cdrfiuba/seguidor_de_linea/models/Rueda.FCStd

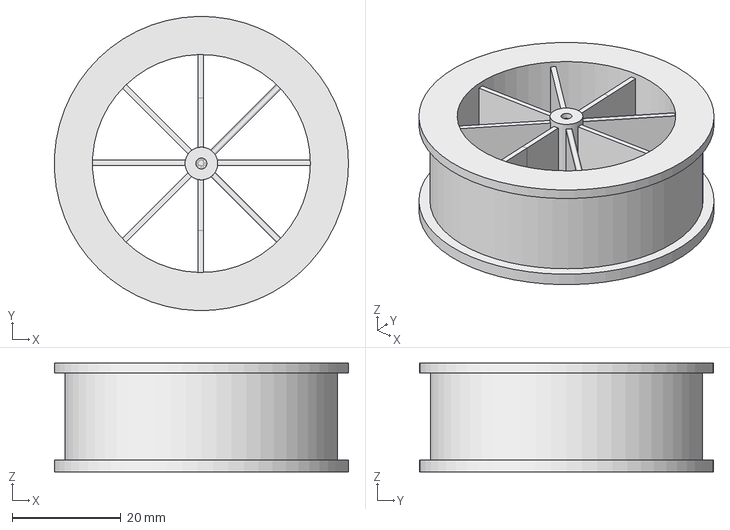
[picture p29: CAD file, 2025-07-30]
models/Rueda.FCStd
54.0 x 54.0 x 20.0 mm
