cdrfiuba/seguidor_de_linea/modulo_seguidor/models/Arduino Nano.stl

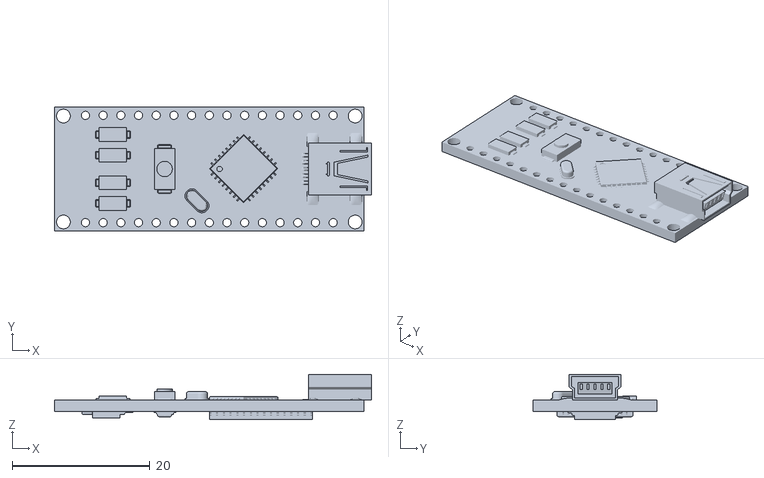
[picture p30: CAD file, 2024-10-13]
modulo_seguidor/models/Arduino Nano.stl
46.1 x 18.0 x 6.55
