cdrfiuba/seguidor_de_linea/modulo_sensor/exports/modulo_sensor.step

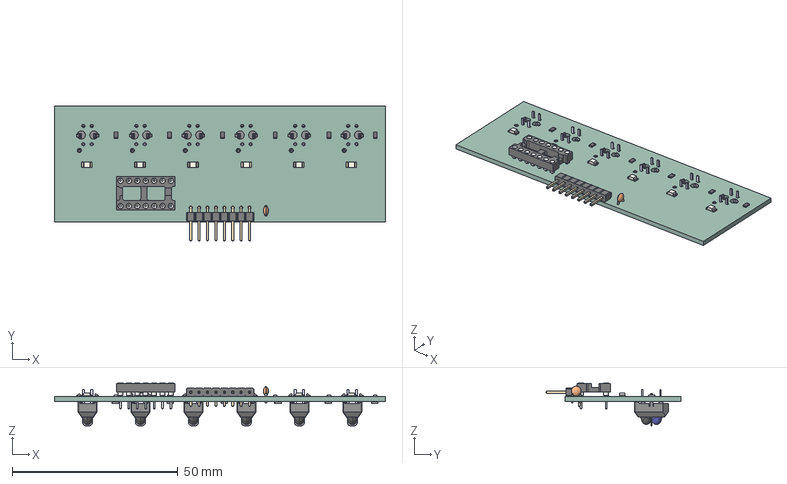
[picture p31: CAD file, 2025-07-29]
modulo_sensor/exports/modulo_sensor.step
100.0 x 40.7 x 12.9 mm
PinHeader_1x08_P2.54mm_Horizontal
R_0805_2012Metric x 18
LED_1206_3216Metric x 6
DIP-14_W7.62mm_Socket
C_Disc_D3.0mm_W1.6mm_P2.50mm
TCRT5000 x 6
modulo_sensor_PCB
