cdrfiuba/seguidor_de_linea/modulo_sensor/step/74HC14DR2G.step

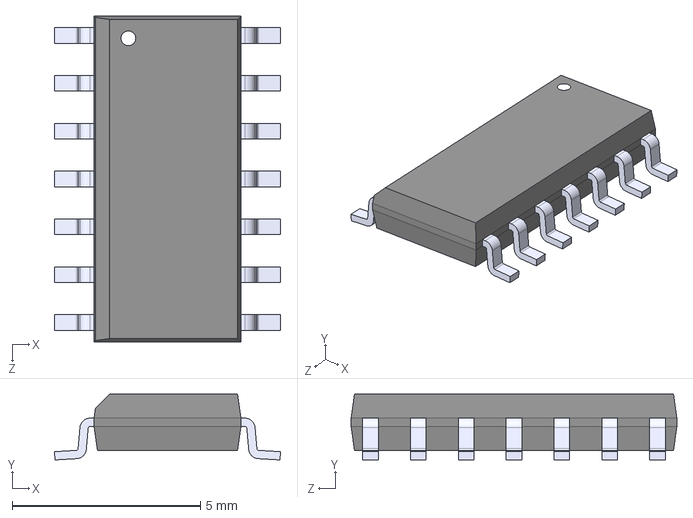
[picture p32: CAD file, 2025-07-29]
modulo_sensor/step/74HC14DR2G.step
6.00 x 1.75 x 8.65 mm
