cdrfiuba/seguidor_de_linea/modulo_sensor/step/TCRT5000.step

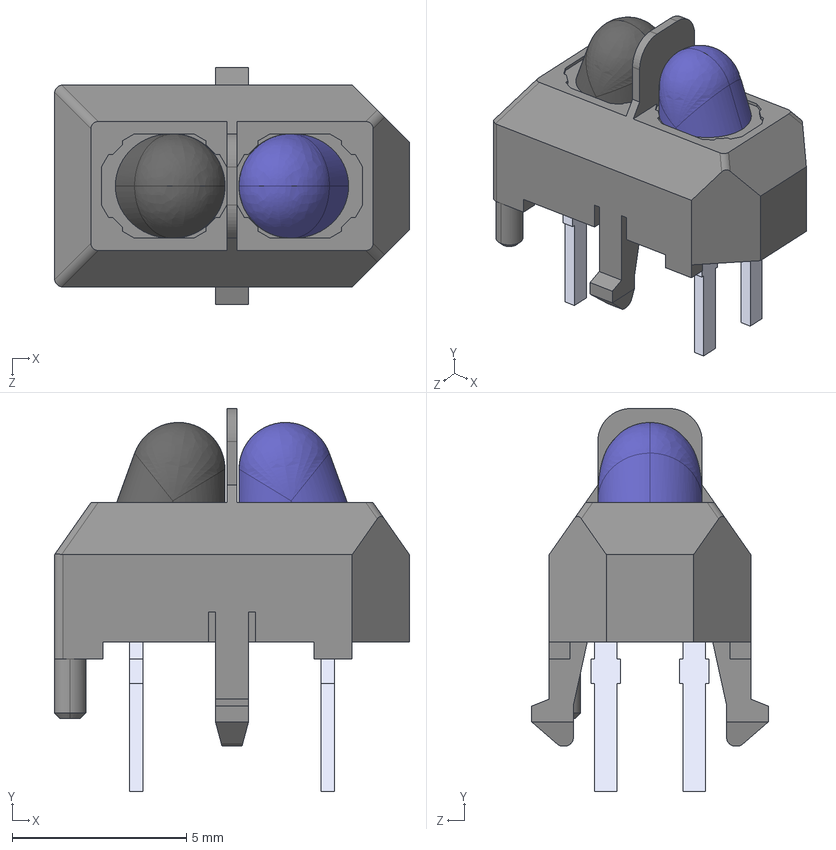
[picture p33: CAD file, 2025-07-29]
modulo_sensor/step/TCRT5000.step
10.2 x 11.0 x 6.80 mm
