cdrfiuba/seguidor_de_linea/modulo_seguidor/modulo_seguidor.kicad_pcb

## KiCad design modulo_seguidor/modulo_seguidor.kicad_pcb (2025-08-12)

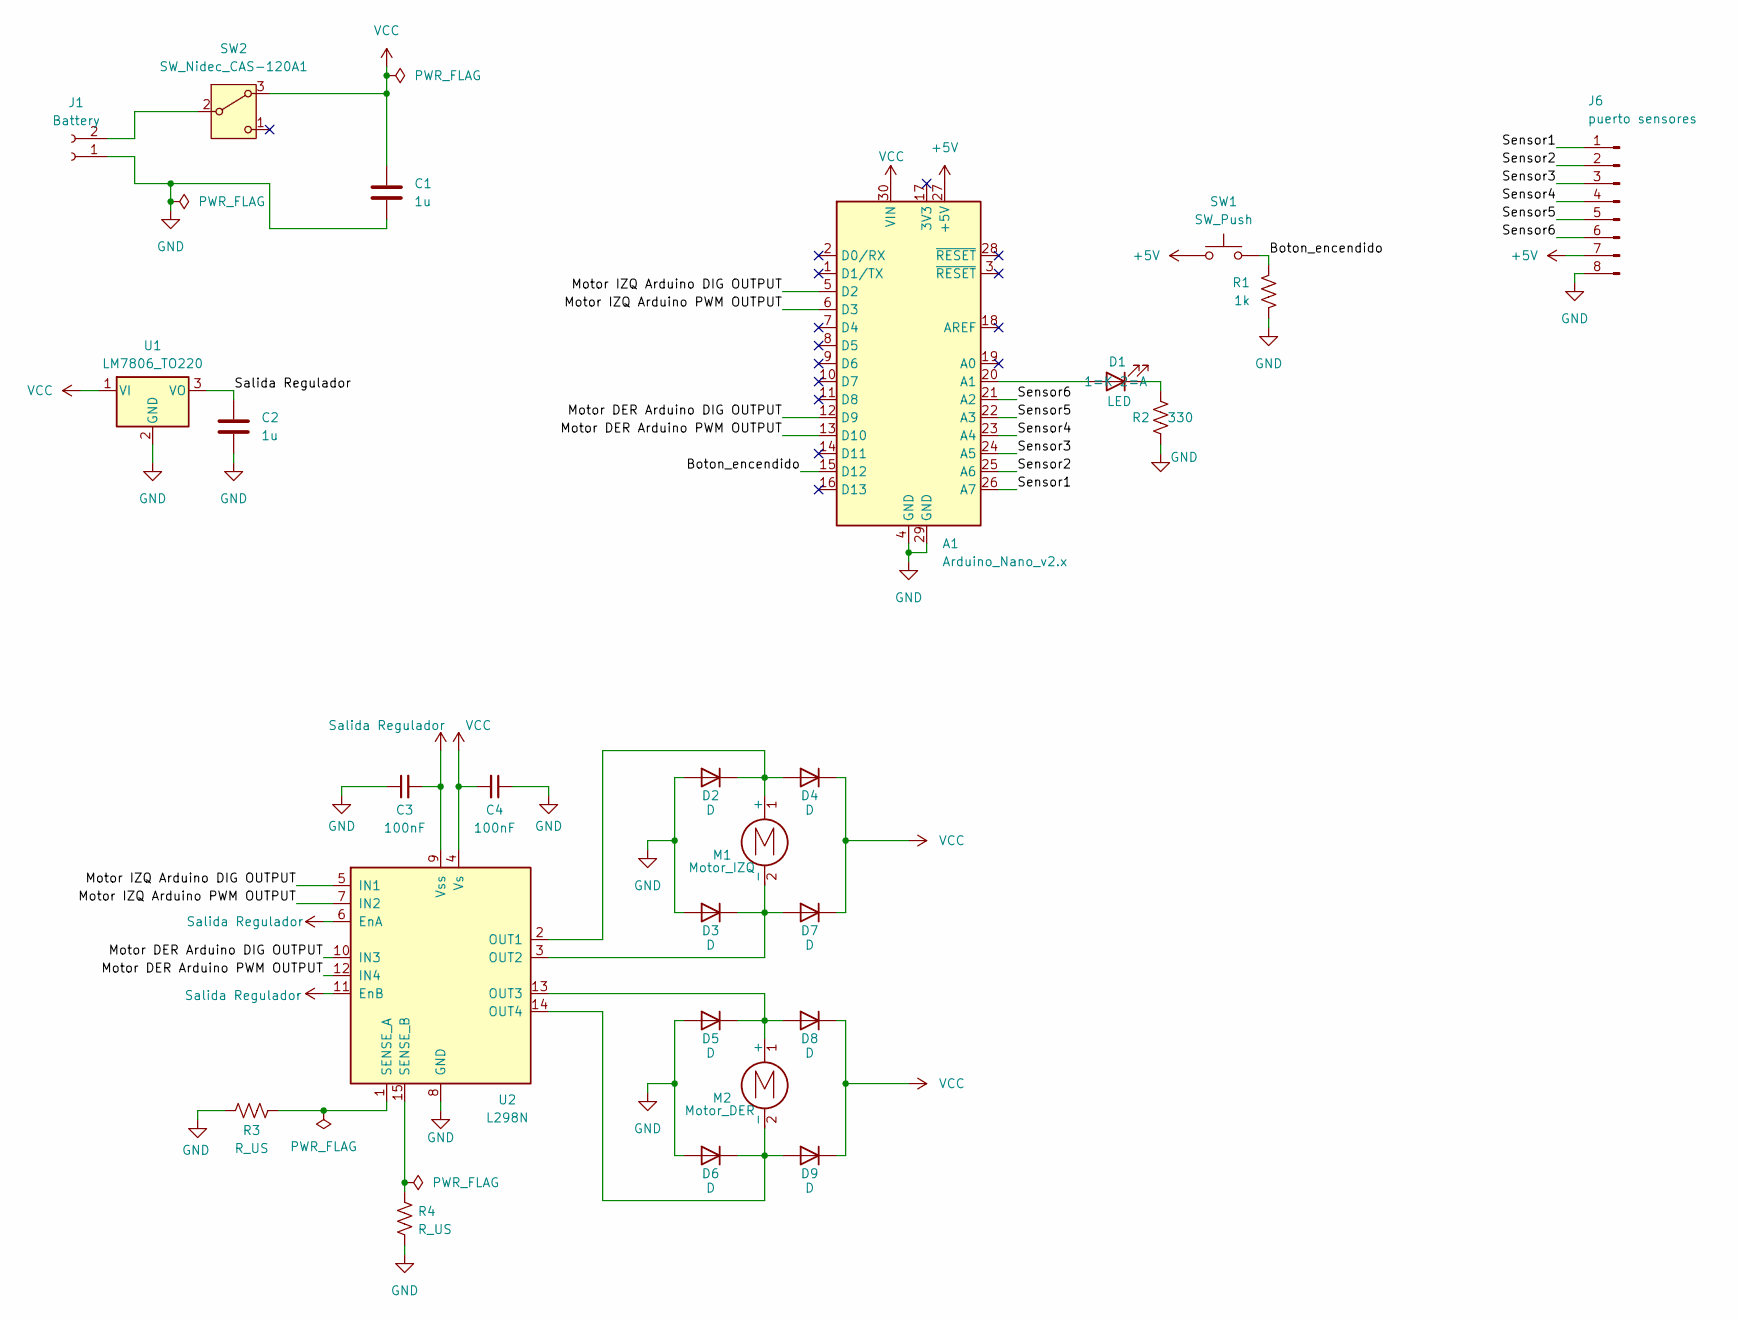
[picture p34: schematic modulo_seguidor.kicad_sch]

Parts:
A1: Arduino_Nano_v2.x; Arduino_Nano
C1, C2: 1u; C_1206_3216Metric_Pad1.33x1.80mm_HandSolder
C3, C4: 100nF; C_1206_3216Metric_Pad1.33x1.80mm_HandSolder
D1: LED; LED_D5.0mm
D2, D3, D4, D5, D6, D7, D8, D9: D; D_DO-41_SOD81_P7.62mm_Horizontal
J1: Battery; Molex_KK-254_AE-6410-02A_1x02_P2.54mm_Vertical
J6: puerto sensores; PinHeader_1x08_P2.54mm_Vertical
M1: Motor_IZQ; Molex_KK-254_AE-6410-02A_1x02_P2.54mm_Vertical
M2: Motor_DER; Molex_KK-254_AE-6410-02A_1x02_P2.54mm_Vertical
R1: 1k; R_1206_3216Metric_Pad1.30x1.75mm_HandSolder
R2: 330; R_1206_3216Metric_Pad1.30x1.75mm_HandSolder
R3, R4: R_US; R_0805_2012Metric_Pad1.20x1.40mm_HandSolder
SW1: SW_Push; SW_PUSH_6mm
SW2: SW_Nidec_CAS-120A1; Converter_DCDC_TRACO_TSR2-xxxx_THT
U1: LM7806_TO220; TO-220-3_Vertical
U2: L298N; TO-220-15_P2.54x5.08mm_StaggerOdd_Lead4.58mm_Vertical

Connections:
+5V: A1.27 (+5V), J6.7, SW1.1
/Boton_encendido: A1.15 (D12), R1.1, SW1.2
/Motor DER Arduino DIG OUTPUT: A1.12 (D9), U2.10 (IN3)
/Motor DER Arduino PWM OUTPUT: A1.13 (D10), U2.12 (IN4)
/Motor IZQ Arduino DIG OUTPUT: A1.5 (D2), U2.5 (IN1)
/Motor IZQ Arduino PWM OUTPUT: A1.6 (D3), U2.7 (IN2)
/Sensor1: A1.26 (A7), J6.1
/Sensor2: A1.25 (A6), J6.2
/Sensor3: A1.24 (A5), J6.3
/Sensor4: A1.23 (A4), J6.4
/Sensor5: A1.22 (A3), J6.5
/Sensor6: A1.21 (A2), J6.6
GND: A1.4 (GND), A1.29 (GND), C1.2, C2.2, C3.1, C4.1, D2.2 (A), D3.2 (A), D5.2 (A), D6.2 (A), J1.1, J6.8, R1.2, R2.2, R3.2, R4.1, U1.2 (GND), U2.8 (GND)
unnamed: A1.20 (A1), D1.2 (A)
unnamed: D1.1 (K), R2.1
unnamed: D2.1 (K), D4.2 (A), M1.1 (+), U2.2 (OUT1)
unnamed: D3.1 (K), D7.2 (A), M1.2 (-), U2.3 (OUT2)
unnamed: D5.1 (K), D8.2 (A), M2.1 (+), U2.13 (OUT3)
unnamed: D6.1 (K), D9.2 (A), M2.2 (-), U2.14 (OUT4)
unnamed: J1.2, SW2.2 (B)
unnamed: R3.1, U2.1 (SENSE_A)
unnamed: R4.2, U2.15 (SENSE_B)
Salida Regulador: C2.1, C3.2, U1.3 (VO), U2.6 (EnA), U2.9 (Vss), U2.11 (EnB)
VCC: A1.30 (VIN), C1.1, C4.2, D4.1 (K), D7.1 (K), D8.1 (K), D9.1 (K), SW2.3 (A), U1.1 (VI), U2.4 (Vs)

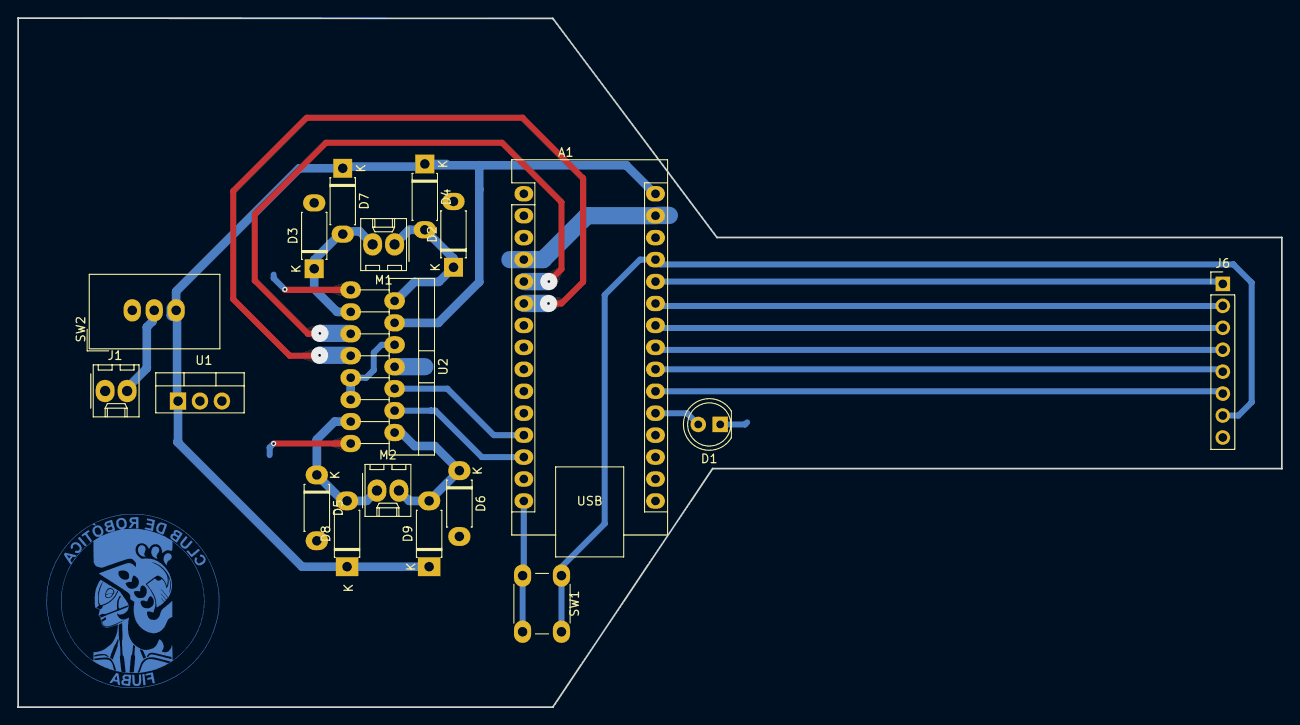
[picture p35: board modulo_seguidor.kicad_pcb from above]

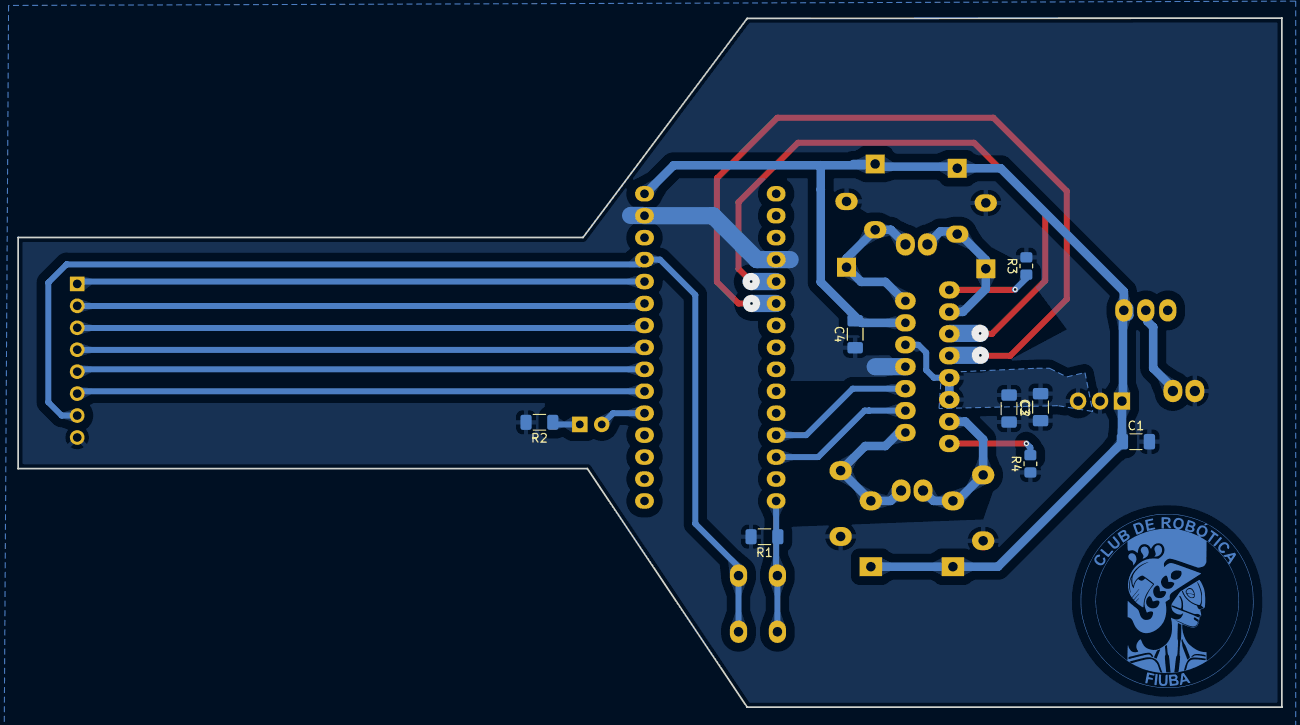
[picture p36: board modulo_seguidor.kicad_pcb from below]

Board: 2 copper layers, 146.3 x 79.8 mm, 26 parts (8 on the bottom side), 24 nets.
