cdrfiuba/seguidor_de_linea/modulo_sensor/modulo_sensor.kicad_pcb

## KiCad design modulo_sensor/modulo_sensor.kicad_pcb (2025-07-30)

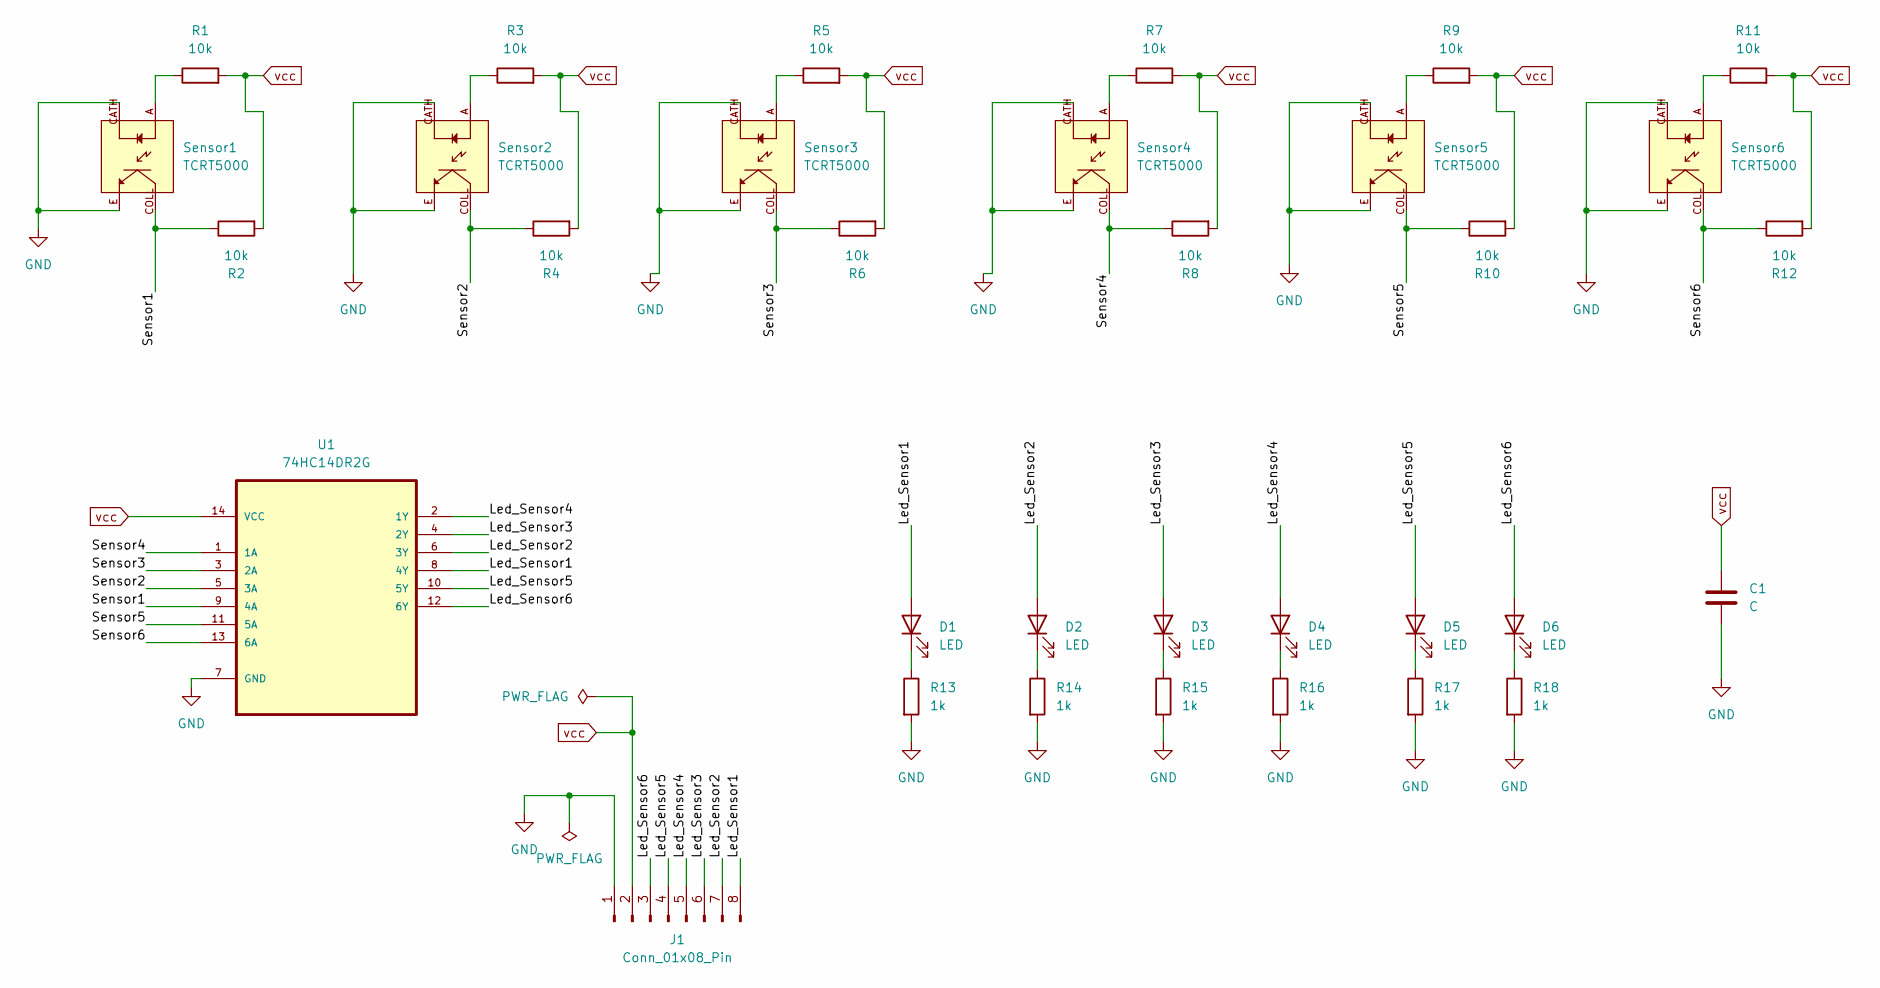
[picture p37: schematic modulo_sensor.kicad_sch]

Parts:
C1: C; C_Disc_D3.0mm_W1.6mm_P2.50mm
D1, D2, D3, D4, D5, D6: LED; LED_1206_3216Metric_Pad1.42x1.75mm_HandSolder
J1: Conn_01x08_Pin; PinHeader_1x08_P2.54mm_Horizontal
R1, R2, R3, R4, R5, R6, R7, R8, R9, R10, R11, R12: 10k; R_0805_2012Metric_Pad1.20x1.40mm_HandSolder
R13, R14, R15, R16, R17, R18: 1k; R_0805_2012Metric_Pad1.20x1.40mm_HandSolder
Sensor1, Sensor2, Sensor3, Sensor4, Sensor5, Sensor6: TCRT5000; OPTO_TCRT5000_ancho; PARTREV 1.7
U1: 74HC14DR2G; DIP-14_W7.62mm_Socket; MPN 74HC14DR2G

Connections:
/Led_Sensor1: D1.2 (A), J1.8, U1.8 (4Y)
/Led_Sensor2: D2.2 (A), J1.7, U1.6 (3Y)
/Led_Sensor3: D3.2 (A), J1.6, U1.4 (2Y)
/Led_Sensor4: D4.2 (A), J1.5, U1.2 (1Y)
/Led_Sensor5: D5.2 (A), J1.4, U1.10 (5Y)
/Led_Sensor6: D6.2 (A), J1.3, U1.12 (6Y)
/Sensor1: R2.1, Sensor1.COLL, U1.9 (4A)
/Sensor2: R4.1, Sensor2.COLL, U1.5 (3A)
/Sensor3: R6.1, Sensor3.COLL, U1.3 (2A)
/Sensor4: R8.1, Sensor4.COLL, U1.1 (1A)
/Sensor5: R10.1, Sensor5.COLL, U1.11 (5A)
/Sensor6: R12.1, Sensor6.COLL, U1.13 (6A)
GND: C1.2, J1.1, R13.2, R14.2, R15.2, R16.2, R17.2, R18.2, Sensor1.CATH, Sensor1.E, Sensor2.CATH, Sensor2.E, Sensor3.CATH, Sensor3.E, Sensor4.CATH, Sensor4.E, Sensor5.CATH, Sensor5.E, Sensor6.CATH, Sensor6.E, U1.7 (GND)
unnamed: D1.1 (K), R13.1
unnamed: D2.1 (K), R14.1
unnamed: D3.1 (K), R15.1
unnamed: D4.1 (K), R16.1
unnamed: D5.1 (K), R17.1
unnamed: D6.1 (K), R18.1
unnamed: R1.1, Sensor1.A
unnamed: R3.1, Sensor2.A
unnamed: R5.1, Sensor3.A
unnamed: R7.1, Sensor4.A
unnamed: R9.1, Sensor5.A
unnamed: R11.1, Sensor6.A
vcc: C1.1, J1.2, R1.2, R2.2, R3.2, R4.2, R5.2, R6.2, R7.2, R8.2, R9.2, R10.2, R11.2, R12.2, U1.14 (VCC)

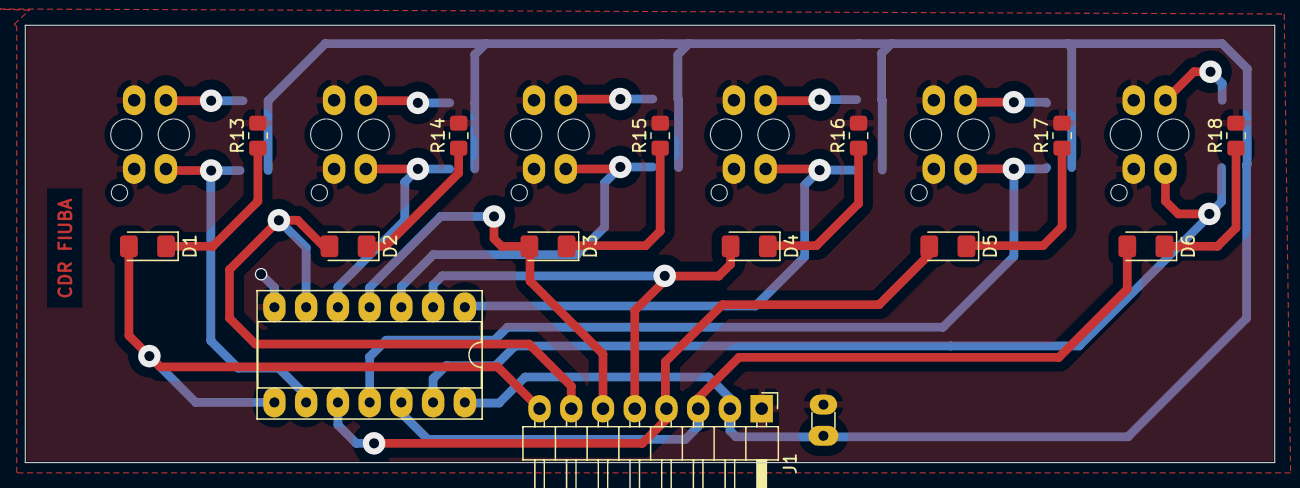
[picture p38: board modulo_sensor.kicad_pcb from above]

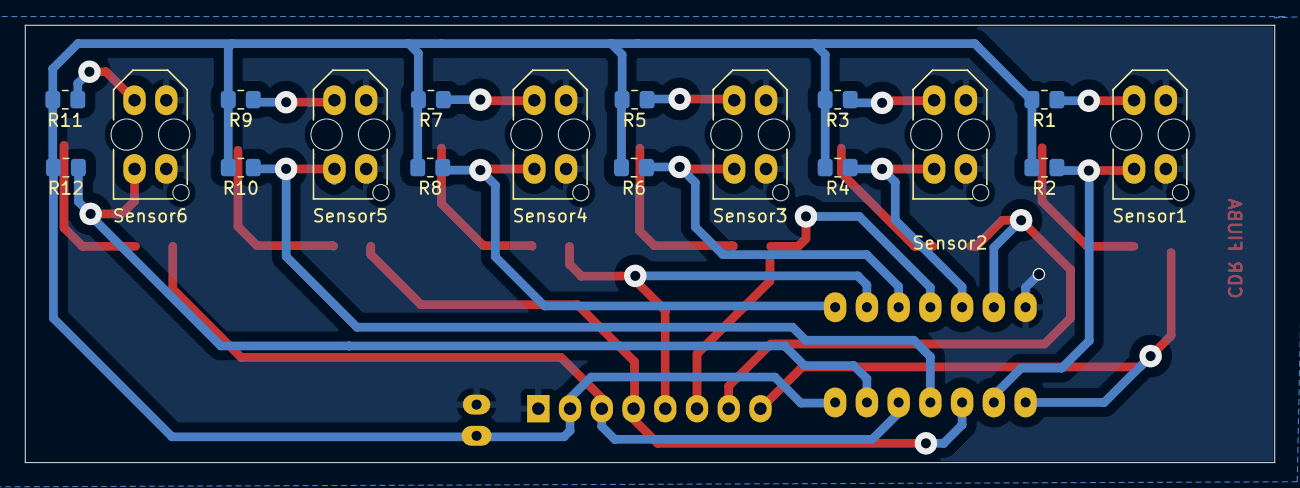
[picture p39: board modulo_sensor.kicad_pcb from below]

Board: 2 copper layers, 100.0 x 35.0 mm, 33 parts (18 on the bottom side), 26 nets.
