cdrfiuba/seguidor_de_linea/modulo_sensor/referencia_modulo.kicad_pcb

## KiCad design modulo_sensor/referencia_modulo.kicad_pcb (2025-07-29)

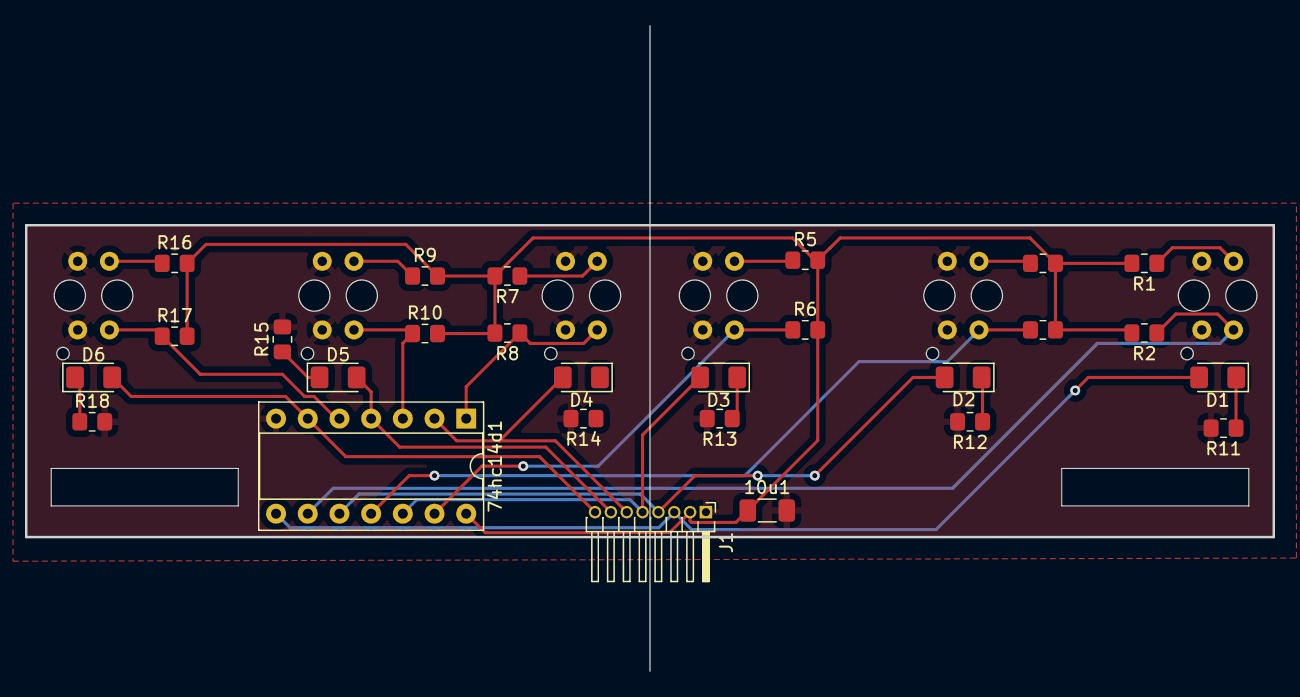
[picture p40: board referencia_modulo.kicad_pcb from above]

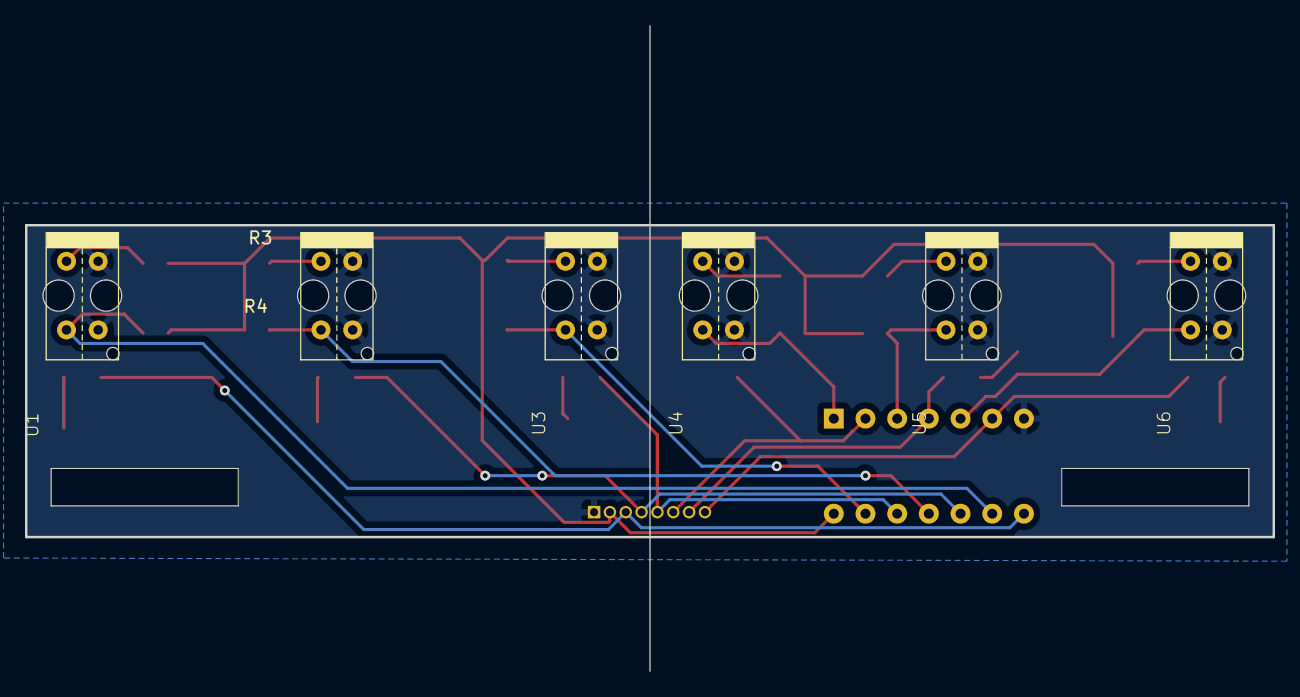
[picture p41: board referencia_modulo.kicad_pcb from below]

Board: 2 copper layers, 100.0 x 25.0 mm, 33 parts (6 on the bottom side), 26 nets.

Parts:
10u1: CAP; C_1206_3216Metric_Pad1.33x1.80mm_HandSolder
74hc14d1: A_14-LC-TT; DIP-14_W7.62mm_Socket
D1, D2, D3, D4, D5, D6: LED; LED_1206_3216Metric_Pad1.42x1.75mm_HandSolder
J1: Conn_01x08_Pin; PinHeader_1x08_P1.27mm_Horizontal
R1, R3, R5, R7, R9, R16: 220; R_0805_2012Metric_Pad1.20x1.40mm_HandSolder
R2, R4, R6, R8, R10, R17: 10k; R_0805_2012Metric_Pad1.20x1.40mm_HandSolder
R11, R12, R13, R14, R15, R18: 1k; R_0805_2012Metric_Pad1.20x1.40mm_HandSolder
U1, U2, U3, U4, U5, U6: TCMT4106; tcrt5000

Connections:
/sensor1: 74hc14d1.8, D1.2 (A), J1.3
/sensor1_unfiltered: 74hc14d1.9, R2.1, U1.16
/sensor2: 74hc14d1.10, D2.2 (A), J1.4
/sensor2_unfiltered: 74hc14d1.11, R4.1, U2.16
/sensor3: 74hc14d1.12, D3.2 (A), J1.5
/sensor3_unfiltered: 74hc14d1.13, R6.1, U3.16
/sensor4: 74hc14d1.2, D4.2 (A), J1.6
/sensor4_unfiltered: 74hc14d1.1, R8.1, U4.16
/sensor5: 74hc14d1.4, D5.2 (A), J1.7
/sensor5_unfiltered: 74hc14d1.3, R10.1, U5.16
/sensor6: 74hc14d1.6, D6.2 (A), J1.8
/sensor6_unfiltered: 74hc14d1.5, R17.1, U6.16
GND: 10u1.2, 74hc14d1.7, J1.1, R11.2, R12.2, R13.2, R14.2, R15.2, R18.2, U1.2, U1.15, U2.2, U2.15, U3.2, U3.15, U4.2, U4.15, U5.2, U5.15, U6.2, U6.15
unnamed: D1.1 (K), R11.1
unnamed: D2.1 (K), R12.1
unnamed: D3.1 (K), R13.1
unnamed: D4.1 (K), R14.1
unnamed: D5.1 (K), R15.1
unnamed: D6.1 (K), R18.1
unnamed: R1.1, U1.1
unnamed: R3.1, U2.1
unnamed: R5.1, U3.1
unnamed: R7.1, U4.1
unnamed: R9.1, U5.1
unnamed: R16.1, U6.1
VCC: 10u1.1, 74hc14d1.14, J1.2, R1.2, R2.2, R3.2, R4.2, R5.2, R6.2, R7.2, R8.2, R9.2, R10.2, R16.2, R17.2
