cdrfiuba/seguidor_de_linea/src/test_max_value.h

#include "pins.h"
#include "config.h"

void mysetup() {
    setupMotorPins();
}

void myloop() {
    digitalWrite(PIN_MOTOR_DER_DIG, LOW);
    digitalWrite(PIN_MOTOR_IZQ_DIG, LOW);
    analogWrite(PIN_MOTOR_DER_PWM, MAX_VALUE_MOTOR_DER);
    analogWrite(PIN_MOTOR_IZQ_PWM, MAX_VALUE_MOTOR_IZQ);
}
