cdrfiuba/seguidor_de_linea/(commit log)

2024-09-18 docs: Boceto de la estructura del proyecto
2024-09-18 docs: Agregados requisitos para el robot
2024-09-18 docs: Agrego imágenes de referencia
2024-09-18 docs: agregar todos para organizar el avance
2024-09-18 docs: Agrego el reglamento de carrera de la Liga Nacional de Robótica
2024-09-22 docs: Agrego TODOs discutidos en la semana 3
2024-09-28 doc: Agrego datasheets de los sensores infrarrojos y del schmitt-trigger
2024-09-28 feat: Agrego proyecto de kicad del modulo de sensores
    [modulo_sensor.kicad_pcb, modulo_sensor.kicad_sch]
2024-09-28 feat: Agrego librerias del sensor TCRT5000
    Liberías de símbolos, huellas y ste|p (modelo 3D)
    [TCRT5000.step]
2024-09-28 fix: Agrego la tabla de símbolos
2024-09-28 feat: Agrego libería del 74HC14DR2G
    Librería de símbolos, footprints y step
    [74HC14DR2G.step]
2024-09-28 chore: Update de las configuraciones del modulo sensor
2024-09-28 feat: Agrego esquemático del sensor
    [modulo_sensor.kicad_sch]
2024-09-28 fix: Actualizo los valores de las resistencias y el footprint del led
    [modulo_sensor.kicad_sch]
2024-09-28 feat: pcb del modelo en versión horizontal, faltan conectar cosas
    Falta conectar la tierra y vcc
    [modulo_sensor_horizontal.kicad_pcb]
2024-09-28 feat: pcb del modulo de sensores con el 74HC en vertical
    [modulo_sensor.kicad_pcb]
2024-09-28 feat: Agrego referencia de la placa de sensores del SDL anterior
    [referencia_modulo.kicad_pcb]
2024-09-28 refactor: Intercambio los labels de los pines y del 74HC para acomodarlos en la pcb
    [modulo_sensor.kicad_sch]
2024-09-28 feat: diseño casi funcional de la pcb del modulo sensores.
    Todas las conexiones están hechas pero hay warnings y errores del DRC.
    [modulo_sensor.kicad_pcb]
2024-09-28 feat: Agrego agujeros a la placa para atornillar al chasis
    [modulo_sensor.kicad_pcb]
2024-09-28 refactor: Cambio los footprints de todas las resistencias THT por SMD
    [modulo_sensor.kicad_pcb, modulo_sensor.kicad_sch]
2024-09-28 refactor: Reduzco la distancia entre los sensores centrales dentro de 20mm
    Ahora hay 18,07mm de centro a centro en los sensores 3 y 4
    [modulo_sensor.kicad_pcb]
2024-09-28 fix: Arreglo algunas conexiones sueltas y relleno B.Cu con GND
    [modulo_sensor.kicad_pcb]
2024-09-28 refactor: Elimino boceto con el 74HC horizontal
    [modulo_sensor_horizontal.kicad_pcb]
2024-09-28 fix: Reruteo las pistas que pasan entre los leds, y alejo las pistas entre sí
    [modulo_sensor.kicad_pcb]
2024-09-29 docs: Agrego preview de la pcb.
    En el README se dejaran notas y una preview del último estado de la pcb
    [modulo_sensor.kicad_pcb]
2024-09-29 feat: Script para automatizar exportar el svg desde cli en linux
    Dar permiso con chmod +x ./export.sh
2024-09-29 docs: Agrego proporción a la preview
2024-10-01 refactor: Pongo el integrado en horizontal
    Está todo conectado como antes
    [modulo_sensor.kicad_pcb]
2024-10-01 fix: Guardo el archivo (fallo del commit anterior)
    [modulo_sensor.kicad_pcb]
2024-10-01 refactor: Los sensores ahora están en la capa de abajo
    [modulo_sensor.kicad_pcb]
2024-10-01 refactor: Cambio las huellas de los led por SMDs
    [modulo_sensor.kicad_pcb]
2024-10-01 fix: Actualizo la preview
2024-10-01 fix: Cambio las huellas de los leds por smd en el esquemático
    [modulo_sensor.kicad_sch]
2024-10-02 feat: Reestructuro la placa a doble faz y pasa el DRC sin errores
    [modulo_sensor.kicad_pcb, modulo_sensor.kicad_sch]
2024-10-02 feat: Agrego los modelos 3D para el visor 3D de KiCad
    [modulo_sensor.kicad_pcb]
2024-10-02 refactor: Reacomodos menores y reduzco el tamaño de la placa
    [modulo_sensor.kicad_pcb]
2024-10-02 feat: Actualizo el script para exportar preview de B y F
2024-10-02 refactor: Reodeno los pines para acomodarlos en la pcb
    [modulo_sensor.kicad_sch]
2024-10-02 refactor: Reorganizo la pcb y la hago más chica
    [modulo_sensor.kicad_pcb]
2024-10-02 feat: Agrego archivos de fabricación
    [modulo_sensor-B_Cu.gbr, modulo_sensor-B_Mask.gbr, modulo_sensor-B_Paste.gbr, modulo_sensor-B_Silkscreen.gbr, modulo_sensor-Edge_Cuts.gbr, modulo_sensor-F_Cu.gbr, modulo_sensor-F_Mask.gbr, modulo_sensor-F_Paste.gbr]
2024-10-02 chore: Pequeño cambio de configuracion del kicad_pro
    [modulo_sensor.kicad_pcb]
2024-10-02 refactor: Reduzo la placa para redondear la medida
    [modulo_sensor-B_Cu.gbr, modulo_sensor-B_Mask.gbr, modulo_sensor-B_Paste.gbr, modulo_sensor-B_Silkscreen.gbr, modulo_sensor-Edge_Cuts.gbr, modulo_sensor-F_Cu.gbr, modulo_sensor-F_Mask.gbr, modulo_sensor-F_Paste.gbr]
2024-10-02 fix: No había guardado en el anterior commit
    [modulo_sensor-B_Cu.gbr, modulo_sensor-B_Mask.gbr, modulo_sensor-B_Paste.gbr, modulo_sensor-B_Silkscreen.gbr, modulo_sensor-Edge_Cuts.gbr, modulo_sensor-F_Cu.gbr, modulo_sensor-F_Mask.gbr, modulo_sensor-F_Paste.gbr]
2024-10-03 refactor: Cambio de margen de rutas a 0,3mm y arreglo algunos checks
    Las infracciones son por la cercania de los pines del conector J1
    [modulo_sensor.kicad_pcb]
2024-10-03 fix: Arreglo las previews que no se actualizó
2024-10-05 refactor: Actualizo el ancho de las pistas a 0,6
    [modulo_sensor.kicad_pcb]
2024-10-05 fix: Agrego valor a la huella del capacitor
    [modulo_sensor.kicad_pcb]
2024-10-05 refactor: Actualizo los archivos de fabricación
    [modulo_sensor-B_Cu.gbr, modulo_sensor-B_Mask.gbr, modulo_sensor-B_Paste.gbr, modulo_sensor-B_Silkscreen.gbr, modulo_sensor-Edge_Cuts.gbr, modulo_sensor-F_Cu.gbr, modulo_sensor-F_Mask.gbr, modulo_sensor-F_Paste.gbr]
2024-10-05 feat: Archivo .zip con los archivos de fabricación actualizados
2024-10-05 docs: Agrego TODOs para editar en el script
2024-10-05 fix: Agrego exclusiones a las infracciones de margen de los pines de J1
2024-10-05 feat: Actualizo el README con TODOs y muevo las previews
2024-10-05 feat: El script ahora puede exportar los archivos de fabricación
2024-10-05 refactor: Alejo pistas de los bordes (por las dudas)
    [modulo_sensor-B_Cu.gbr, modulo_sensor-B_Mask.gbr, modulo_sensor-B_Paste.gbr, modulo_sensor-B_Silkscreen.gbr, modulo_sensor-Edge_Cuts.gbr, modulo_sensor-F_Cu.gbr, modulo_sensor-F_Mask.gbr, modulo_sensor-F_Paste.gbr]
2024-10-06 docs: Agrego imagen con el pinout del arduino Nano
2024-10-06 feat: Agrego esquemático de la placa del seguidor
    [modulo_seguidor.kicad_sch]
2024-10-06 feat: Aplico configuraciones para simular una perfboard para el diseño
2024-10-06 feat: Asigno las huellas a los componentes
    [modulo_seguidor.kicad_sch]
2024-10-06 docs: Documento el modulo seguidor
2024-10-06 refactor: Actualizo huellas del esquemático
    [modulo_seguidor.kicad_sch]
2024-10-06 feat: Agrego boceto de la placa del modulo seguidor y su preview
    [modulo_seguidor.kicad_pcb]
2024-10-06 style: Agrego las medidas de los lados en la pcb del modulo seguidor
    [modulo_seguidor.kicad_pcb]
2024-10-06 docs: Agrego TODOs, previews y documento la placa del modulo_seguidor
    [modulo_seguidor.kicad_pcb]
2024-10-06 fix: Arreglo la preview del modulo seguidor con el nuevo archivo
2024-10-06 fix: Arreglo previews rotas del modulo sensor
2024-10-06 fix: Actualizo archivos de fabricación a la última versión
    [modulo_sensor-B_Cu.gbr, modulo_sensor-B_Mask.gbr, modulo_sensor-B_Paste.gbr, modulo_sensor-B_Silkscreen.gbr, modulo_sensor-Edge_Cuts.gbr, modulo_sensor-F_Cu.gbr, modulo_sensor-F_Mask.gbr, modulo_sensor-F_Paste.gbr]
2024-10-06 fix: Arreglo las previews del modulo sensor
2024-10-09 refactor: Cambio ancho de pistas en el modulo sensor a 0,7mm
    [modulo_sensor.kicad_pcb]
2024-10-09 chore: Agrego aclaración para el led D6 espejado
    [modulo_sensor.kicad_pcb]
2024-10-09 feat: Actualizo las previews del modulo sensor a la ultima versión
2024-10-09 feat: Agrego argumentos al script para indicarle exportar la fabricacion
2024-10-12 style: Acomodo las referencias en la pcb del sensor
    [modulo_sensor.kicad_pcb]
2024-10-12 docs: Agrego documento de ayuda sobre el diseño de las pcbs
2024-10-12 feat: Agrego los cables en la pcb del modulo seguidor
    [modulo_seguidor.kicad_pcb]
2024-10-12 refactor: Reordeno la pcb del modulo seguidor y sus conexiones
    [modulo_seguidor.kicad_pcb]
2024-10-12 refactor: Hago las conexiones n poco más cortas y rectas
    [modulo_seguidor.kicad_pcb]
2024-10-13 feat: Agrego modelo 3d .wrl del arduino nano
    [modulo_seguidor.kicad_pcb]
2024-10-13 refactor: Cambio las conexiones en los pines del modulo seguidor para compactar la pcb
    [Arduino Nano.stl, modulo_seguidor.kicad_pcb, modulo_seguidor.kicad_sch]
2024-10-13 refactor(modulo_seguidor): Intercambio dos pines para hacer los cables más cortos
    [modulo_seguidor.kicad_pcb, modulo_seguidor.kicad_sch]
2024-10-13 feat(modulo_seguidor): Agrego partes no perforadas y lo referencio en la documentacion
    [modulo_seguidor.kicad_pcb]
2024-10-13 docs: Elimino TODOs de la lista
2024-10-13 refactor(modulo_sensor): Elimino archivos de fabricacion
    Los archivos estarán disponibles en las releases junto con los modelos y
    otros archivos finales del proyecto.
    [modulo_sensor-B_Cu.gbr, modulo_sensor-B_Mask.gbr, modulo_sensor-B_Paste.gbr, modulo_sensor-B_Silkscreen.gbr, modulo_sensor-Edge_Cuts.gbr, modulo_sensor-F_Cu.gbr, modulo_sensor-F_Mask.gbr, modulo_sensor-F_Paste.gbr]
2024-10-13 faet(modulo_sensor): El script exporta un modelo 3D del pcb
    [modulo_sensor.step]
2024-10-19 refactor(modulo_sensor): Cambio la huella del pin por una de 2,5mm
    [modulo_sensor.kicad_pcb, modulo_sensor.kicad_sch]
2024-10-19 docs(modulo_sensor): Actualizo las previews
    [modulo_sensor.step]
2024-10-19 refactor(modulo_sensor): Acomodo algunas pistas de cobre
    [modulo_sensor.kicad_pcb]
2024-11-04 res: Agrego datasheet del regulador de tensión
2024-11-04 feat(seguidor): Agrego puente H y motores al esquemático
    [modulo_seguidor.kicad_sch]
2024-11-05 test(modulo_sensor): Agrego test para los sensores
2024-11-05 docs: Agrego lista de articulos pendientes
2024-11-05 Agrego en lista de compras
2024-11-05 res(referencias): Agrego referencias para el uso del puente H
2024-11-16 feat(puente-h): Agrego esquemático del puente H
    [modulo_puente_h.kicad_sch, modulo_seguidor.kicad_sch]
2024-11-16 fix(puente-h): Las salidas de sensor no tenian PWR_FLAG
    [modulo_puente_h.kicad_sch]
2024-11-17 refactor(puente-h):Modifico el orden de los pines de conexión
    [modulo_puente_h.kicad_sch]
2024-11-17 feat(puente-h): Agrego pcb del puente H
    [modulo_puente_h.kicad_pcb]
2024-11-17 docs(puente-h): Agrego documentacion y vista previa de la placa
2024-11-17 refactor(puente-h): Reordeno los pines
    [modulo_puente_h.kicad_sch]
2024-11-17 refactor(puente-h): Achico la placa
    [modulo_puente_h.kicad_pcb]
2024-11-17 docs(puente-h): Actualizo la preview de la placa
2024-11-22 docs(puente-h): Link colgado de una imagen anterior
2024-11-22 feat(modulo-sensor): Agrego vías y actualizo las previews del circuito
    Commit de Cinthia
    [modulo_sensor.kicad_pcb, modulo_sensor.kicad_sch, modulo_sensor.step]
2024-12-06 fix: Las pistas van del lado de las soldaduras
    No se puede soldar en el plástico :/
    [modulo_puente_h.kicad_pcb]
2025-03-30 refactor!: Update de versión Kicad y corrijo nombres del esquemático
    [modulo_puente_h.kicad_pcb, modulo_puente_h.kicad_sch]
2025-03-30 fix: Agrego PWR_FLAGs para el ERC de Kicad y footprint del l298
    [modulo_puente_h.kicad_sch]
2025-03-30 refactor: Reorganizo las etiquetas de los pines
    [modulo_puente_h.kicad_sch]
2025-03-30 feat(puente-h): Agrego kicad_pcb
    [modulo_puente_h.kicad_pcb]
2025-03-30 refactor(puente-h): Ensancho espacios entre pistas
    [modulo_puente_h.kicad_pcb]
2025-03-30 fix(puente-h): Relleno la zona GND de la PCB
    [modulo_puente_h.kicad_pcb]
2025-04-03 docs(puente-h): Agrego preview en pdf para imprimir
2025-05-10 feat: Added PCB export to PDF
2025-05-10 refactor(modulo_seguidor): Merge del seguidor y el puente H
    [modulo_seguidor.kicad_sch]
2025-05-11 feat(seguidor): Corrijo errores de DRC esquemático
    [modulo_seguidor.kicad_sch]
2025-05-11 feat(modulo-seguidor): Agrego placa con el seguidor y el puente h incluidos
    [modulo_seguidor.kicad_pcb]
2025-05-11 feat(modulo_seguidor): Agrego boceto PCB del seguidor + puente H
    [modulo_seguidor.kicad_pcb]
2025-05-11 refactor(modulo-seguidor): Reorganizo vías y limpio carpeta de puente h
    [modulo_puente_h.kicad_pcb, modulo_puente_h.kicad_sch, modulo_seguidor.kicad_pcb]
2025-05-24 refactor(seguidor): Reordeno los pines del modulo sensor
    [modulo_seguidor.kicad_sch]
2025-05-24 refactor(modulo-seguidor): Cambio resistencia del LED de THT por SMD
    [modulo_seguidor.kicad_sch]
2025-05-24 refactor!(modulo-seguidor): Modifico forma de la placa
    [modulo_seguidor.kicad_pcb]
2025-05-24 refactor(modulo-seguidor): Cambio huella de motores a Housing
    [modulo_seguidor.kicad_sch]
2025-05-24 refactor(modulo-seguidor): Continuo el boceto de la placa
    [modulo_seguidor.kicad_pcb]
2025-05-24 Placa PH - Huellas y ubicaciones
    Cambie las ubicaciones de los pines del arduino que dan a los motores para mejor ubicación
    [modulo_seguidor.kicad_pcb]
2025-05-24 feat(Modulo_seguidor) "Diseño con todo conectado + detalles"
    Cambie de lugar algunos pines del arduino para mejor llega a las conexiones . Entre ellos :
    - Botón Encendido del D15 al D16
    - Encender Botón: de A7 a A1
    - Se deja un especio en el medio donde iría apoyada la batería
    - Las conexiones rojas indican que por arriba se pasará un cable
    Propuesta: Si bien llegué a conectar la salida del regulador a la placa de sensores. Capaz sería conveniente alimentar esa placa con los 5V del arduino
    [modulo_seguidor.kicad_pcb]
2025-05-24 Cambio de pines de motores
    El anterior los había cambiado para probar pero como mi idea ahora es usar housing para conectar con cable por arriba vuelvo a poner las entradas del motor en orden
    PWM A = D ocho
    DIG A = D9
    PWM B = D10
    DIG B = D11
    [modulo_seguidor.kicad_sch]
2025-05-24 Codigo Donatello actualizado
    En base al código que nos pasaron de Donatello le agregué las entradas correspondientes de nuestro seguidor
2025-05-24 Agrego los códigos que había realizado manu
    Para tenerlo a mano
2025-05-24 Diseño Ruedas
    Pueden tener esta forma para que el caucho se agarre bien y no se salgan.
    Pendiente: Tomar medidas de las ruedas de caucho
    [Rueda.FCStd]
2025-05-24 refactor(modulo-seguidor): Cambio conexiones de entrada del l298 por housings
    [modulo_seguidor.kicad_sch]
2025-05-24 chore(modulo-seguidor): Modificaciones de archivo proyecto
2025-05-24 refactor(modulo-seguidor): Redistribución y cambio de entrada del puente por housing
    [modulo_seguidor.kicad_pcb]
2025-05-24 docs: Agrego TODOs para la próxima visita al LABI
2025-05-24 refactor(src): Muevo archivos de lugar
2025-05-25 Nueva placa de sensores mejor centrada
    Cambie de lugar los pines y con ello las conexiones para la versión final del seguidor
    Lo puse en otra carpeta para no borrar la versión actual
    La placa ahora mide exactamente 100 x 35 mm
    [74HC14DR2G.step, TCRT5000.step, modulo_sensor.kicad_pcb, modulo_sensor.kicad_sch, modulo_sensor.step, referencia_modulo.kicad_pcb]
2025-05-26 Agrego pasante de GND para Schmitt Trigger
    El GND del integrado queda muy aislado de todo el gnd, se agrega un pasante para soldar y asegurar que todas las tierras esten conectadas
    [modulo_sensor.kicad_pcb]
2025-05-26 agrego medidas de la placa
    [modulo_sensor.kicad_pcb]
2025-05-27 Cambio de pistas
    el sector de GND del puente H quedaba aislado. Moví un par de cosas para asegurar que todo GND esté conectado
    [modulo_seguidor.kicad_pcb]
2025-05-28 cambio tamaño de ruedas
    Ya saque las medidas de las ruedas y lo plasmé en el programa
    [Rueda.FCStd]
2025-07-04 Tamaño de pads
    [modulo_seguidor.kicad_pcb]
2025-07-26 refactor!(Modulo seguidor): Cambio pines de sensores a analógicos, PWM, pin de botón, y led
    [modulo_seguidor.kicad_sch]
2025-07-26 chore(modulo-seguidor): Cambio la gravedad de serigrafía y gravedad de cercanía de pistas
2025-07-26 refactor(modulo-seguidor): Cambio pines de led y de boton del seguidor
    [modulo_seguidor.kicad_sch]
2025-07-26 refactor!(modulo-seguidor): Actualizo la pcb con los cambios del esquemático
    [modulo_seguidor.kicad_pcb]
2025-07-26 refactor(modulo-seguidor): Acomodo componentes de la batería, y pin de 5v del sensor
    [modulo_seguidor.kicad_pcb]
2025-07-26 reactor(modulo-seguidor): Modifico las pistas de VCC
    Los diodos de ambos motores ahora no son simétricos
    [modulo_seguidor.kicad_sch]
2025-07-26 refactor(modulo-seguidor): Optimizo espacio en la pcb
    [modulo_seguidor.kicad_pcb]
2025-07-26 refactor(modulo-seguidor): Elimino jumpers de entradas de un motor del puente H
    [modulo_seguidor.kicad_sch]
2025-07-26 refactor(modulo-seguidor): Reordeno los componentes del pcb
    [modulo_seguidor.kicad_pcb]
2025-07-26 cambios pequeños
    [modulo_seguidor.kicad_pcb]
2025-07-26 refactor(modulo-seguidor): Actualizo medidas y agrego zonas de exclusion para facilitar soldadura
    [modulo_seguidor.kicad_pcb]
2025-07-27 style(modulo-seguidor): Agrego logo del club como huella
    [modulo_seguidor.kicad_pcb]
2025-07-27 feat(modulo-seguidor): Agrego pequeño script para exportar pdf
2025-07-29 refactor(modulo-sensor): Elimino los archivos de la versión anterior de la placa
    [74HC14DR2G.step, TCRT5000.step, modulo_sensor.kicad_pcb, modulo_sensor.kicad_sch, modulo_sensor.step, referencia_modulo.kicad_pcb]
2025-07-29 refactor(modulo-sensor): Agrego flag explícita para exportar a pdf
2025-07-29 style(modulo-sensor): Cambio las posiciones de las medidas para mejor vista
    [modulo_sensor.kicad_pcb, modulo_sensor.step]
2025-07-29 docs(modulo-seguidor): Actualizo las previews de la placa y agrego un script para exportar
    [modulo_seguidor.kicad_pcb]
2025-07-30 refactor(models): Elimino los archivos de respaldo
    [Rueda.FCStd]
2025-07-30 chore(models): Elimino carpeta duplicada
    Diseños 3D pasa a llamarse models y elimino el archivo viejo
    [Rueda.FCStd]
2025-07-30 fix(modulo-sensor): Arreglo pista no conectada y saco el texto de la capa EdgeCuts
    [modulo_sensor.kicad_pcb]
2025-08-12 refactor(modulo-seguidor): Elimino jumpers por cables soldados
    [modulo_seguidor.kicad_sch]
2025-08-12 refactor(modulo-seguidor): Reordeno la placa y actualizo los cambios del esquemático
    [modulo_seguidor.kicad_pcb]
2025-08-12 style(modulo-seguidor): Acomodo el interruptor de la batería más al centro
    [modulo_seguidor.kicad_pcb]
2025-08-12 chore: Actualizo script para exportar las capas del módulo seguidor en orden
2025-08-12 refactor(modulo-seguidor): Actualizo disposicion de los componentes y agrego preview
2025-10-30 refactor(src): junto los casos en un solo archivo
    decido cual compilar a partir de definir una macro
2025-10-30 feat: agrego configuraciones default para pines y motores
2025-10-30 feat: Agrego test para motores
2025-10-30 docs(src): Agrego breve descripcion de la estructura de src
2025-10-31 feat: Agrego prueba para setear motores al maximo
2025-11-01 feat(src): Agrego setup de pins del boton y el led del seguidor
2025-11-01 fix(src): Corrijo la inclusion del test de motores
    [src.ino]
2025-11-01 refactor(src): Elimino el condicional de cada archivo
2025-11-01 refactor(src): Agrego funcion para configurar todos los pines del seguidor
2025-11-01 feat(src): Porteo las versiones para utilizar los pines definidos en pins.h
2025-11-02 feat(src): Agrego funcion para leer pines de sensores digitales y analogicos con sobrecarga de funciones
2025-11-02 feat(src): Agrego flag para poder leer lineas negras con fondo blanco
2025-11-02 refactor(src): Actualizo la v3 para arrancar con un boton y manejo el led
2025-11-06 fix(src): Corrijo y porteo las versiones que faltaban
    [Codigo_Carrera.h, test_motores.h, v_1_seguidor.h, v_2_seguidor.h, v_3_seguidor.h]
